DAROGRA/SmartBike/mcu avr game 5d rocker joystick.jpg

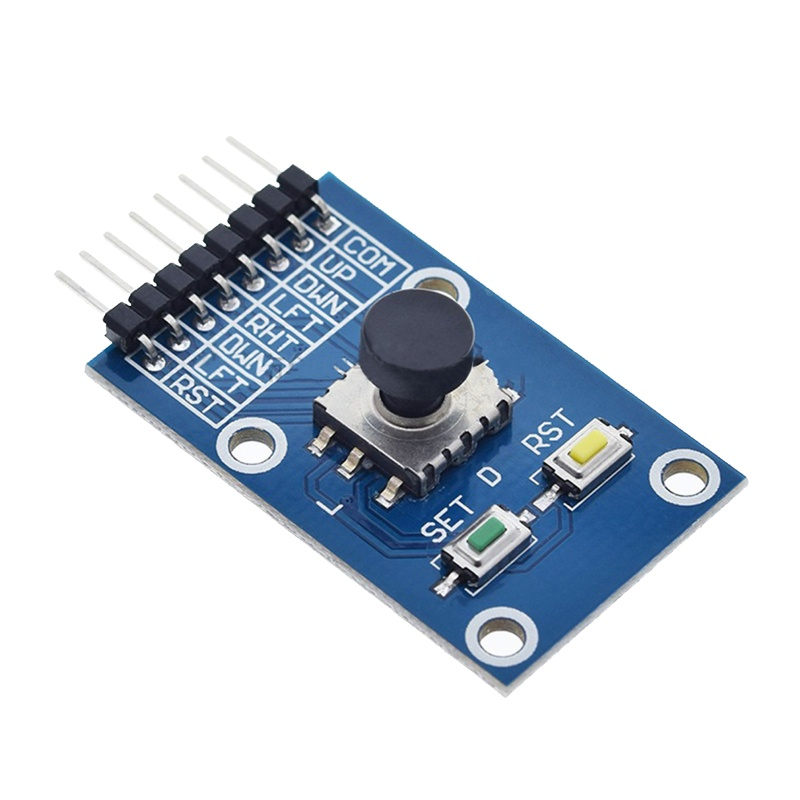
mcu avr game 5d rocker joystick.jpg
