DAROGRA/SmartBike/README.md

# SmartBike
 Proyecto Sistemas Embebidos, para mayor informacion visita la Wiki del proyecto
