DAROGRA/SmartBike/Primer diagrama de bloques.png

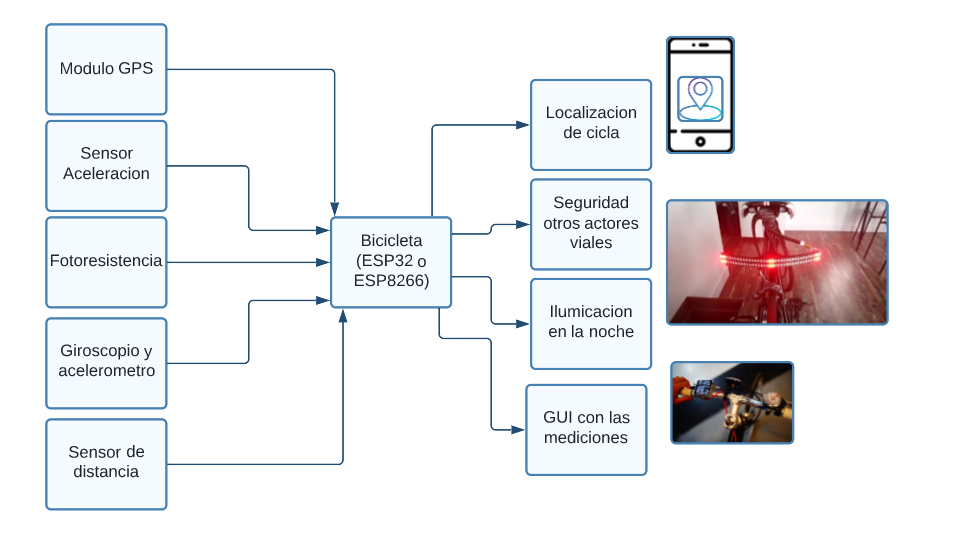
Primer diagrama de bloques.png
