DAROGRA/SmartBike/LIB_ESP32-WROVER-B__8MB_/ESP32-WROVER-B__8MB_/3D/ESP32-WROVER-B__8MB_.stp

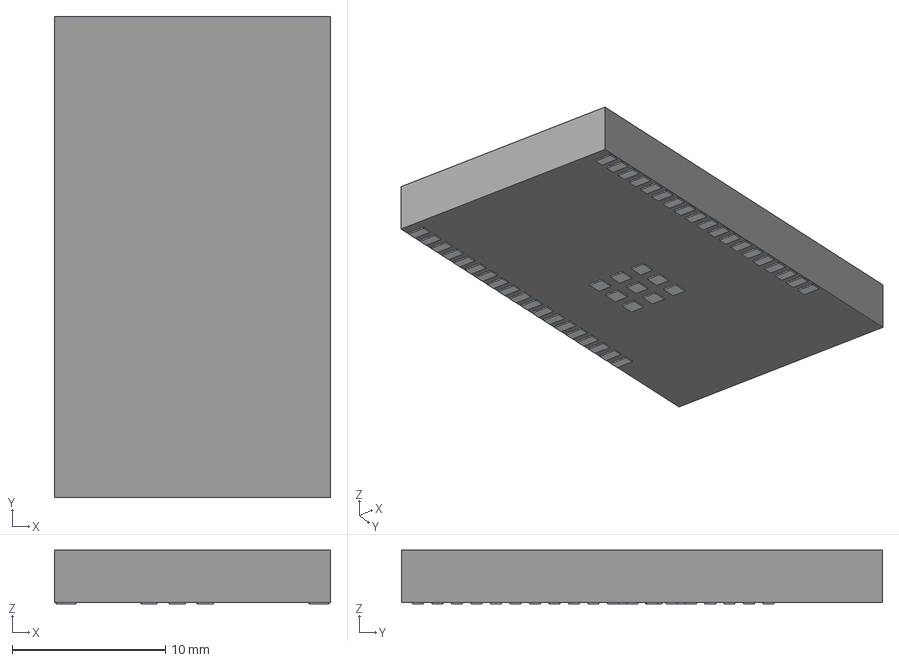
[picture p3: CAD file, 2022-10-04]
LIB_ESP32-WROVER-B__8MB_/ESP32-WROVER-B__8MB_/3D/ESP32-WROVER-B__8MB_.stp
18.0 x 31.4 x 3.50 mm
Pins
