DAROGRA/SmartBike/LIB_SIM800L/SIM800L/3D/SIM800L.stp

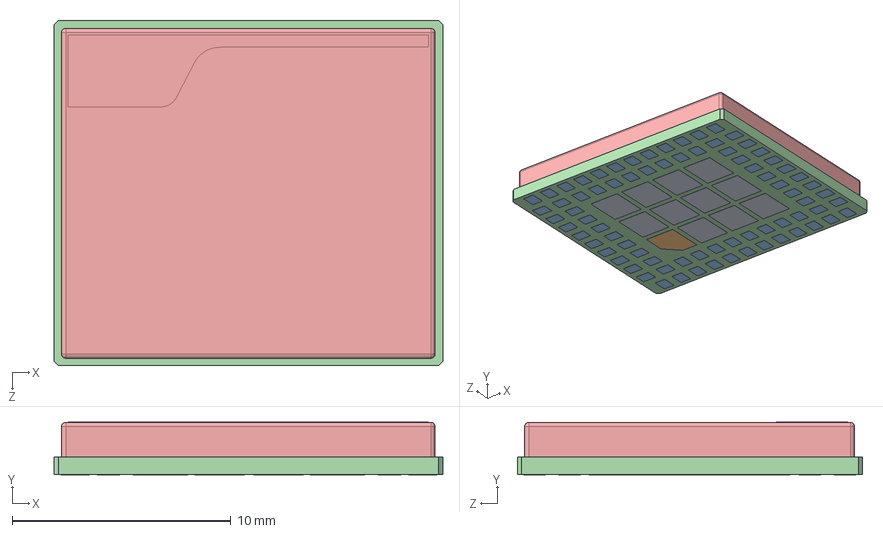
[picture p4: CAD file, 2022-10-04]
LIB_SIM800L/SIM800L/3D/SIM800L.stp
17.8 x 2.42 x 15.8 mm
Pads_D‚faut
PCB_D‚faut
Capot_DＧaut
