DAROGRA/SmartBike/(list of files, cad)

Other CAD files:
LIB_ESP32-WROVER-B__8MB_/ESP32-WROVER-B__8MB_/Allegro/esp32wroverb8mb.psm
LIB_ESP32-WROVER-B__8MB_/ESP32-WROVER-B__8MB_/DEHDL/esp32_wrover_b__8mb_/chips/chips.prt
LIB_NEO-M6-0-001/NEO-M6-0-001/Allegro/neo-m8u.psm
LIB_NEO-M6-0-001/NEO-M6-0-001/DEHDL/neo_m6_0_001/chips/chips.prt
LIB_SIM800L/SIM800L/Allegro/sim800l.psm
LIB_SIM800L/SIM800L/DEHDL/sim800l/chips/chips.prt
