DAROGRA/SmartBike/(list of files, drawings)

Other design files:
Embebidos/EsquemaGeneral.dsn
