DAROGRA/SmartBike/Embebidos/EsquemaGeneral.kicad_pcb

## KiCad design Embebidos/EsquemaGeneral.kicad_pcb (2022-10-22)

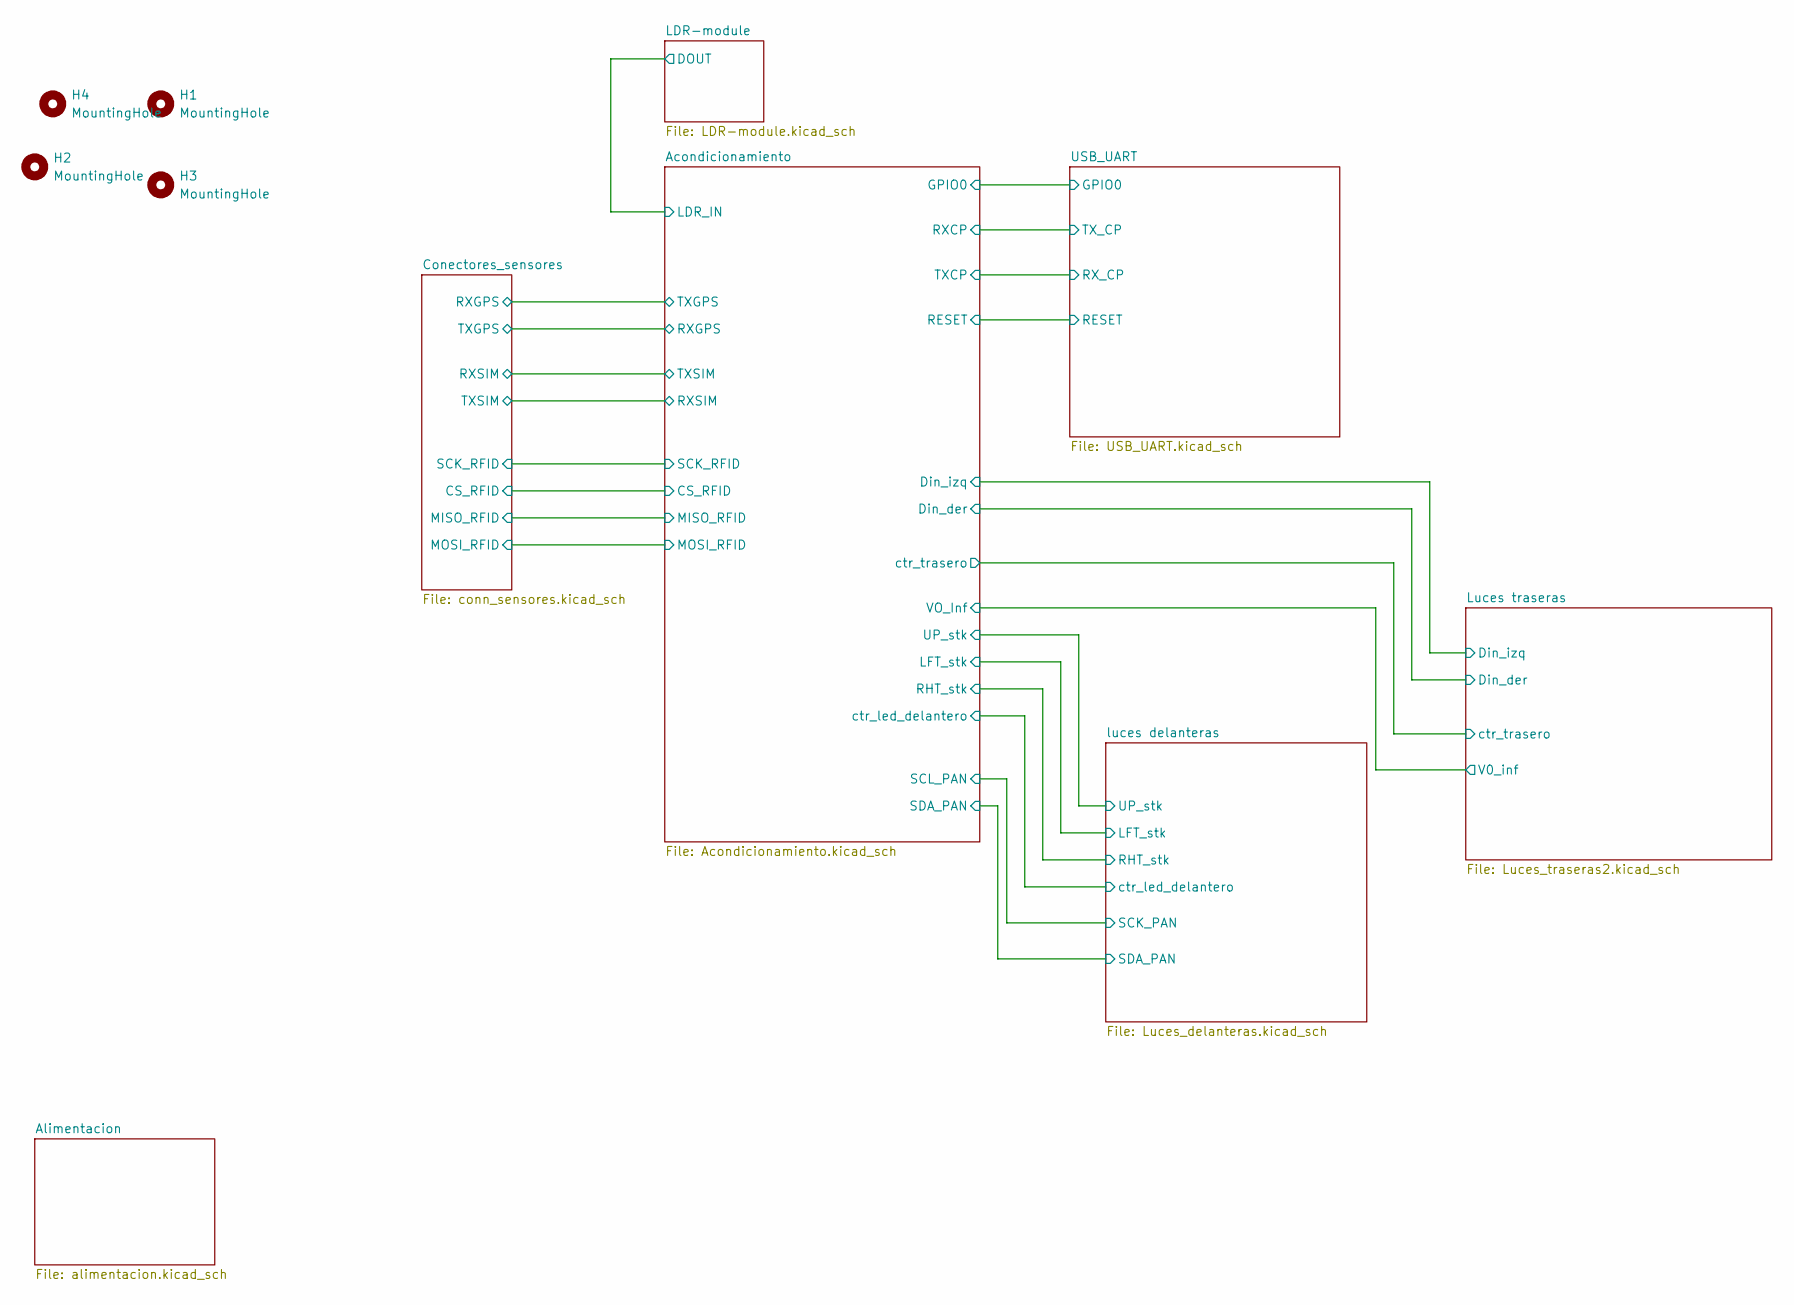
[picture p5: schematic EsquemaGeneral.kicad_sch]

Parts:
H1, H2, H3, H4: MountingHole; MountingHole_2.2mm_M2

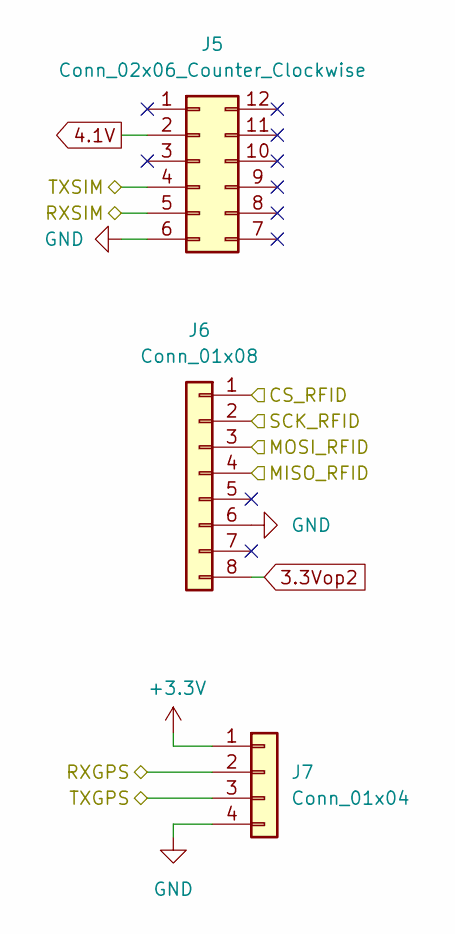
[picture p6: schematic conn_sensores.kicad_sch]

Parts:
J5: Conn_02x06_Counter_Clockwise; sim800l
J6: Conn_01x08; JST_EH_S8B-EH_1x08_P2.50mm_Horizontal
J7: Conn_01x04; JST_EH_B4B-EH-A_1x04_P2.50mm_Vertical

Connections:
3.3Vop2: J6.8; also elsewhere on the board
4.1V: J5.2; also elsewhere on the board
+3.3V: J7.1; also elsewhere on the board
/Acondicionamiento/CS_RFID: J6.1; also elsewhere on the board
/Acondicionamiento/MISO_RFID: J6.4; also elsewhere on the board
/Acondicionamiento/MOSI_RFID: J6.3; also elsewhere on the board
/Acondicionamiento/RXGPS: J7.3; also elsewhere on the board
/Acondicionamiento/RXSIM: J5.4; also elsewhere on the board
/Acondicionamiento/SCK_RFID: J6.2; also elsewhere on the board
/Acondicionamiento/TXGPS: J7.2; also elsewhere on the board
/Acondicionamiento/TXSIM: J5.5; also elsewhere on the board
GND: J5.6, J6.6, J7.4; also elsewhere on the board

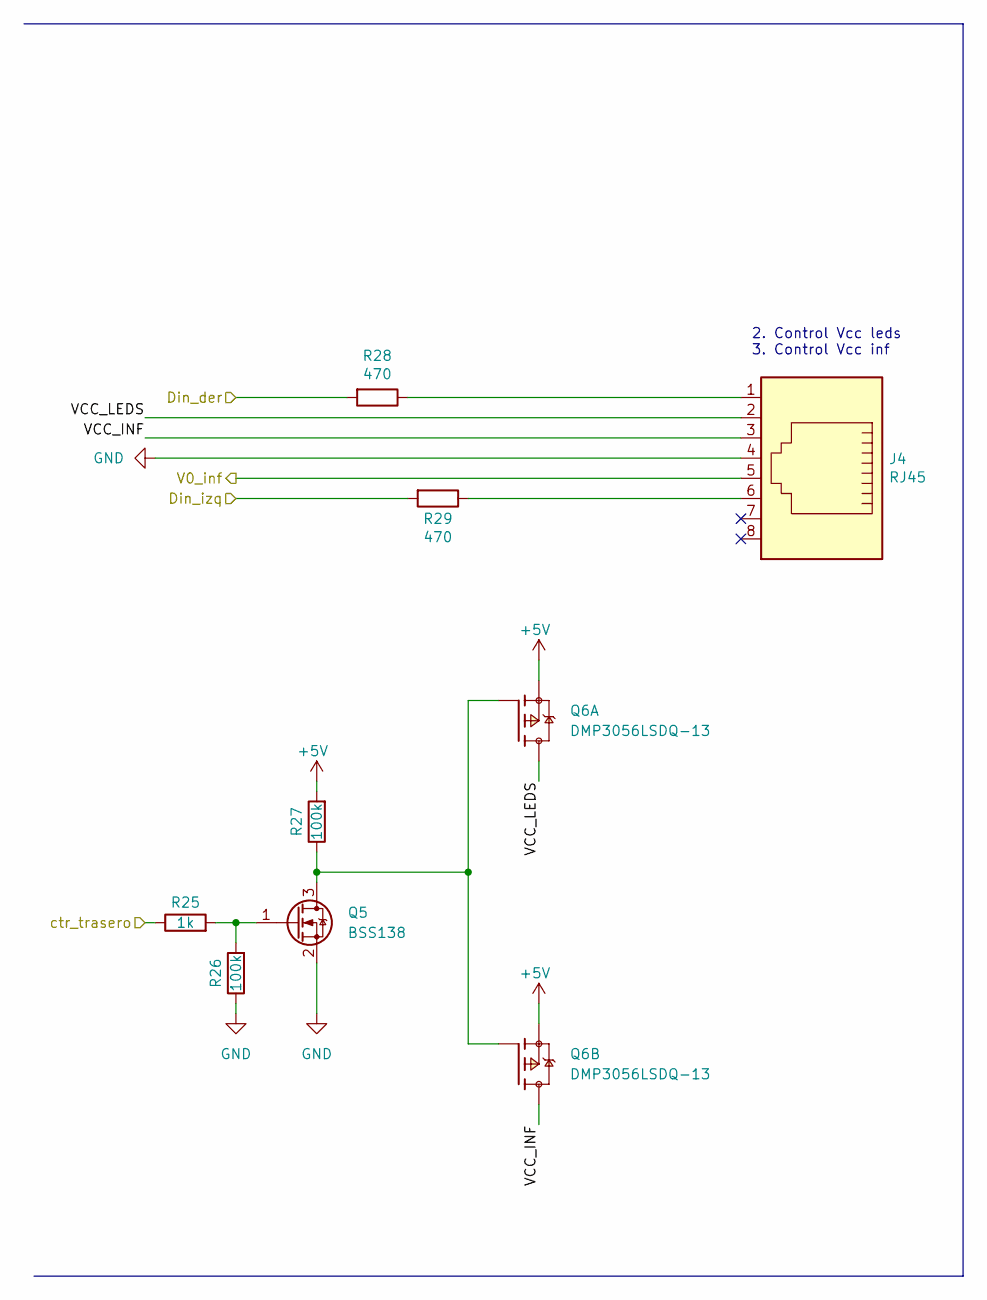
[picture p7: schematic Luces_traseras2.kicad_sch]

Parts:
J4: RJ45; RJ45_Amphenol_54602-x08_Horizontal
Q5: BSS138; SOT-23
Q6: DMP3056LSDQ-13; SOIC127P600X175-8N; PARTREV 1-2
R25: 1k; R_0805_2012Metric_Pad1.20x1.40mm_HandSolder
R26, R27: 100k; R_0805_2012Metric_Pad1.20x1.40mm_HandSolder
R28, R29: 470; R_0805_2012Metric_Pad1.20x1.40mm_HandSolder

Connections:
+5V: Q6.1, Q6.3, R27.2; also elsewhere on the board
/Acondicionamiento/Din_der: R28.2; also elsewhere on the board
/Acondicionamiento/Din_izq: R29.2; also elsewhere on the board
/Acondicionamiento/VO_Inf: J4.5; also elsewhere on the board
/Acondicionamiento/ctr_trasero: R25.1; also elsewhere on the board
/Luces traseras/VCC_INF: J4.3, Q6.5, Q6.6
/Luces traseras/VCC_LEDS: J4.2, Q6.7, Q6.8
GND: J4.4, Q5.2 (S), R26.1; also elsewhere on the board
unnamed: J4.1, R28.1
unnamed: J4.6, R29.1
unnamed: Q5.1 (G), R25.2, R26.2
unnamed: Q5.3 (D), Q6.2, Q6.4, R27.1

Notes on the sheet:
2. Control Vcc leds 3. Control Vcc inf

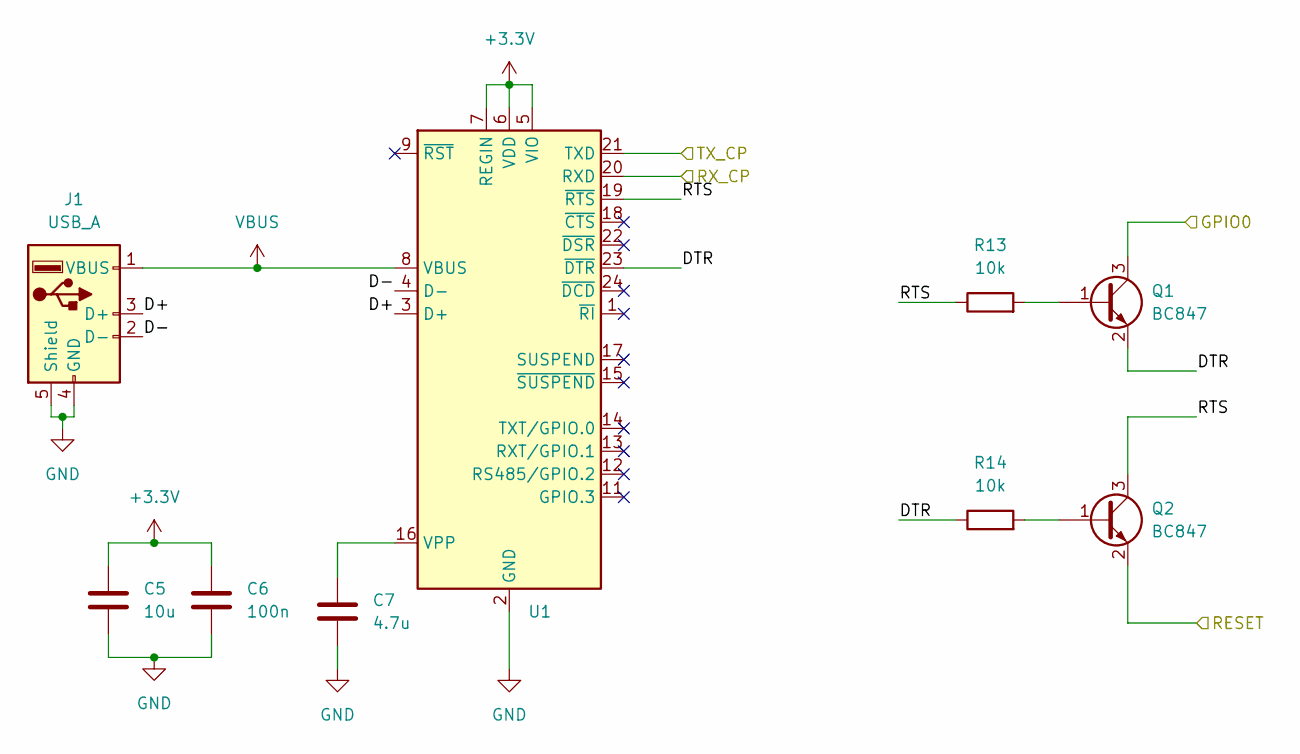
[picture p8: schematic USB_UART.kicad_sch]

Parts:
C5: 10u; C_0805_2012Metric_Pad1.18x1.45mm_HandSolder
C6: 100n; C_0805_2012Metric_Pad1.18x1.45mm_HandSolder
C7: 4.7u; C_0805_2012Metric_Pad1.18x1.45mm_HandSolder
J1: USB_A; USB_A_CNCTech_1001-011-01101_Horizontal
Q1, Q2: BC847; SOT23
R13, R14: 10k; R_0805_2012Metric_Pad1.20x1.40mm_HandSolder
U1: QFN50P400X400X80-25N

Connections:
+3.3V: C5.1, C6.1, U1.5 (VIO), U1.6 (VDD), U1.7 (REGIN); also elsewhere on the board
/Acondicionamiento/GPIO0: Q1.3 (C); also elsewhere on the board
/Acondicionamiento/RESET: Q2.2 (E); also elsewhere on the board
/Acondicionamiento/RXCP: U1.21 (TXD); also elsewhere on the board
/Acondicionamiento/TXCP: U1.20 (RXD); also elsewhere on the board
/USB_UART/D+: J1.3 (D+), U1.3 (D+)
/USB_UART/D-: J1.2 (D-), U1.4 (D-)
/USB_UART/DTR: Q1.2 (E), R14.1, U1.23 (~DTR)
/USB_UART/RTS: Q2.3 (C), R13.1, U1.19 (~RTS)
GND: C5.2, C6.2, C7.2, J1.4 (GND), J1.5 (Shield), U1.2 (GND), U1.25 (GND); also elsewhere on the board
unnamed: C7.1, U1.16 (VPP)
unnamed: Q1.1 (B), R13.2
unnamed: Q2.1 (B), R14.2
VBUS: J1.1 (VBUS), U1.8 (VBUS)

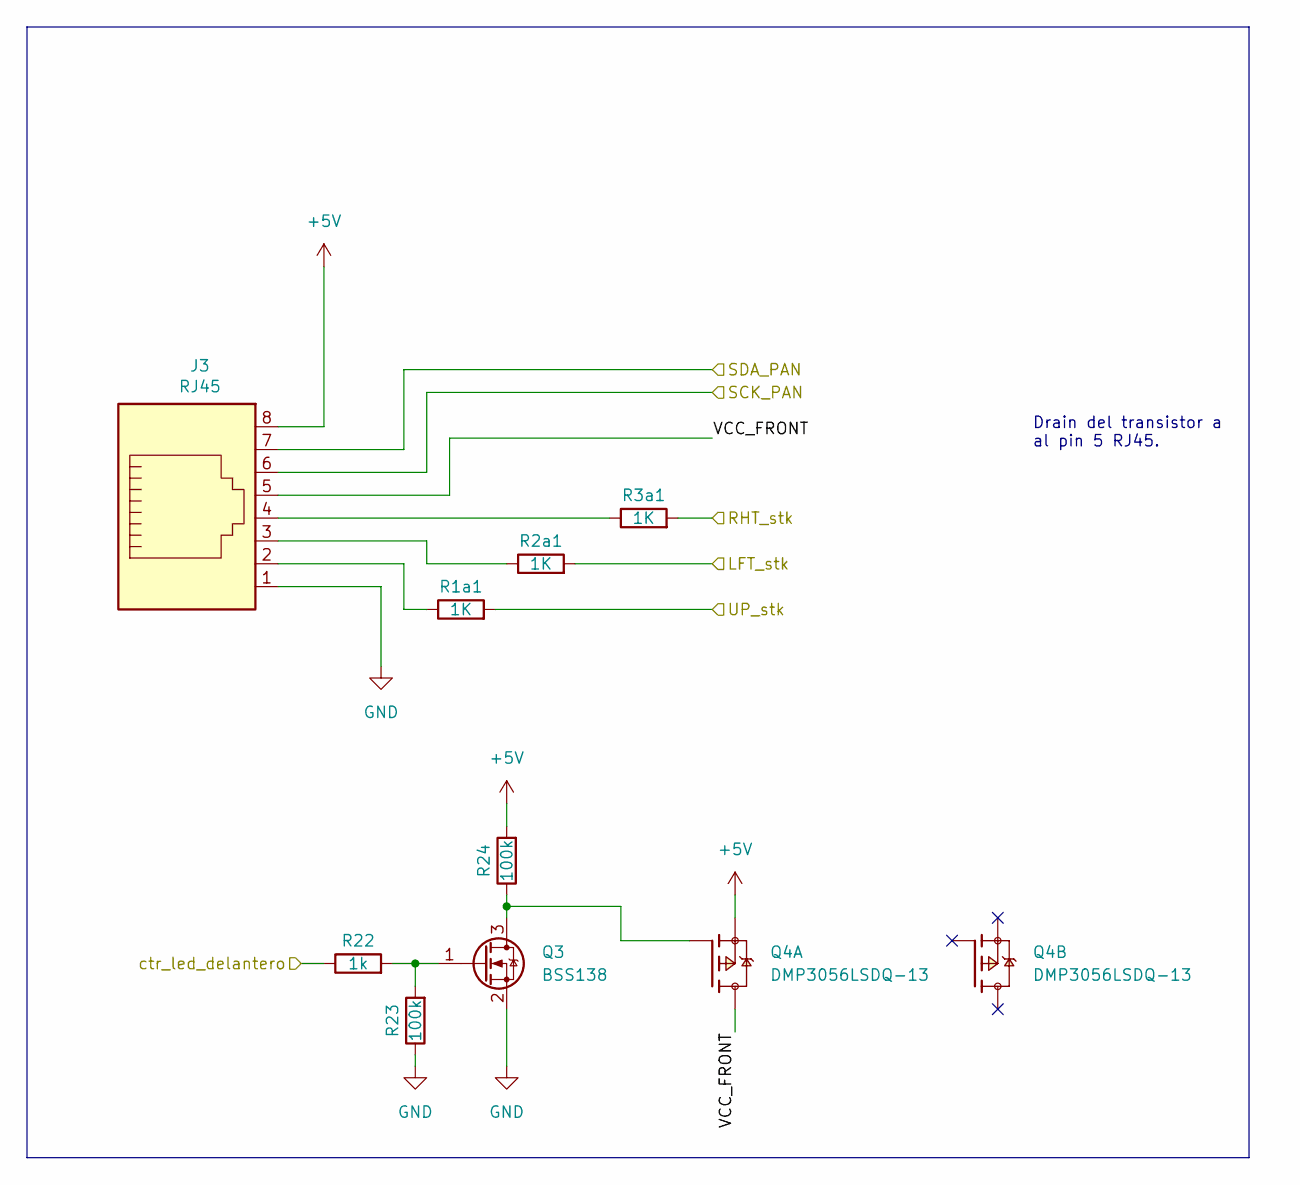
[picture p9: schematic Luces_delanteras.kicad_sch]

Parts:
J3: RJ45; RJ45_Amphenol_54602-x08_Horizontal
Q3: BSS138; SOT-23
Q4: DMP3056LSDQ-13; SOIC127P600X175-8N; PARTREV 1-2
R1a1, R2a1, R3a1: 1K; R_0805_2012Metric_Pad1.20x1.40mm_HandSolder
R22: 1k; R_0805_2012Metric_Pad1.20x1.40mm_HandSolder
R23, R24: 100k; R_0805_2012Metric_Pad1.20x1.40mm_HandSolder

Connections:
+5V: J3.8, Q4.1, R24.2; also elsewhere on the board
/Acondicionamiento/LFT_stk: R2a1.2; also elsewhere on the board
/Acondicionamiento/RHT_stk: R3a1.2; also elsewhere on the board
/Acondicionamiento/SCL_PAN: J3.6; also elsewhere on the board
/Acondicionamiento/SDA_PAN: J3.7; also elsewhere on the board
/Acondicionamiento/UP_stk: R1a1.2; also elsewhere on the board
/Acondicionamiento/ctr_led_delantero: R22.1; also elsewhere on the board
/luces delanteras/VCC_FRONT: J3.5, Q4.7, Q4.8
GND: J3.1, Q3.2 (S), R23.1; also elsewhere on the board
unnamed: J3.2, R1a1.1
unnamed: J3.3, R2a1.1
unnamed: J3.4, R3a1.1
unnamed: Q3.1 (G), R22.2, R23.2
unnamed: Q3.3 (D), Q4.2, R24.1

Notes on the sheet:
Drain del transistor a al pin 5 RJ45.

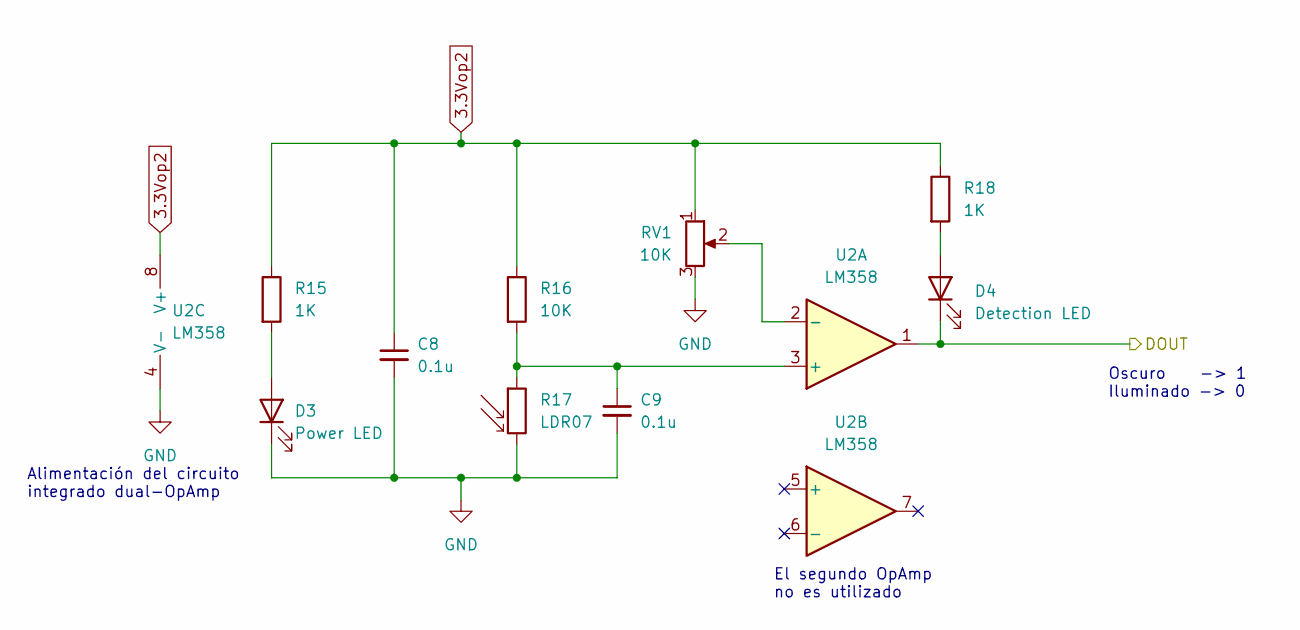
[picture p10: schematic LDR-module.kicad_sch]

Parts:
C8, C9: 0.1u; C_0805_2012Metric_Pad1.18x1.45mm_HandSolder
D3: Power LED; LED_0805_2012Metric_Pad1.15x1.40mm_HandSolder
D4: Detection LED; LED_0805_2012Metric_Pad1.15x1.40mm_HandSolder
R15, R18: 1K; R_0805_2012Metric_Pad1.20x1.40mm_HandSolder
R16: 10K; R_0805_2012Metric_Pad1.20x1.40mm_HandSolder
R17: LDR07; R_LDR_5.1x4.3mm_P3.4mm_Vertical
RV1: 10K; Potentiometer_Bourns_3386P_Vertical
U2: LM358; SOIC127P599X175-8N

Connections:
3.3Vop2: C8.1, R15.1, R16.1, R18.1, RV1.1, U2.8 (V+); also elsewhere on the board
/Acondicionamiento/LDR_IN: D4.1 (K), U2.1; also elsewhere on the board
GND: C8.2, C9.2, D3.1 (K), R17.2, RV1.3, U2.4 (V-); also elsewhere on the board
unnamed: C9.1, R16.2, R17.1, U2.3 (+)
unnamed: D3.2 (A), R15.2
unnamed: D4.2 (A), R18.2
unnamed: RV1.2, U2.2 (-)

Notes on the sheet:
El segundo OpAmp no es utilizado
Alimentación del circuito integrado dual-OpAmp
Oscuro -> 1 Iluminado -> 0

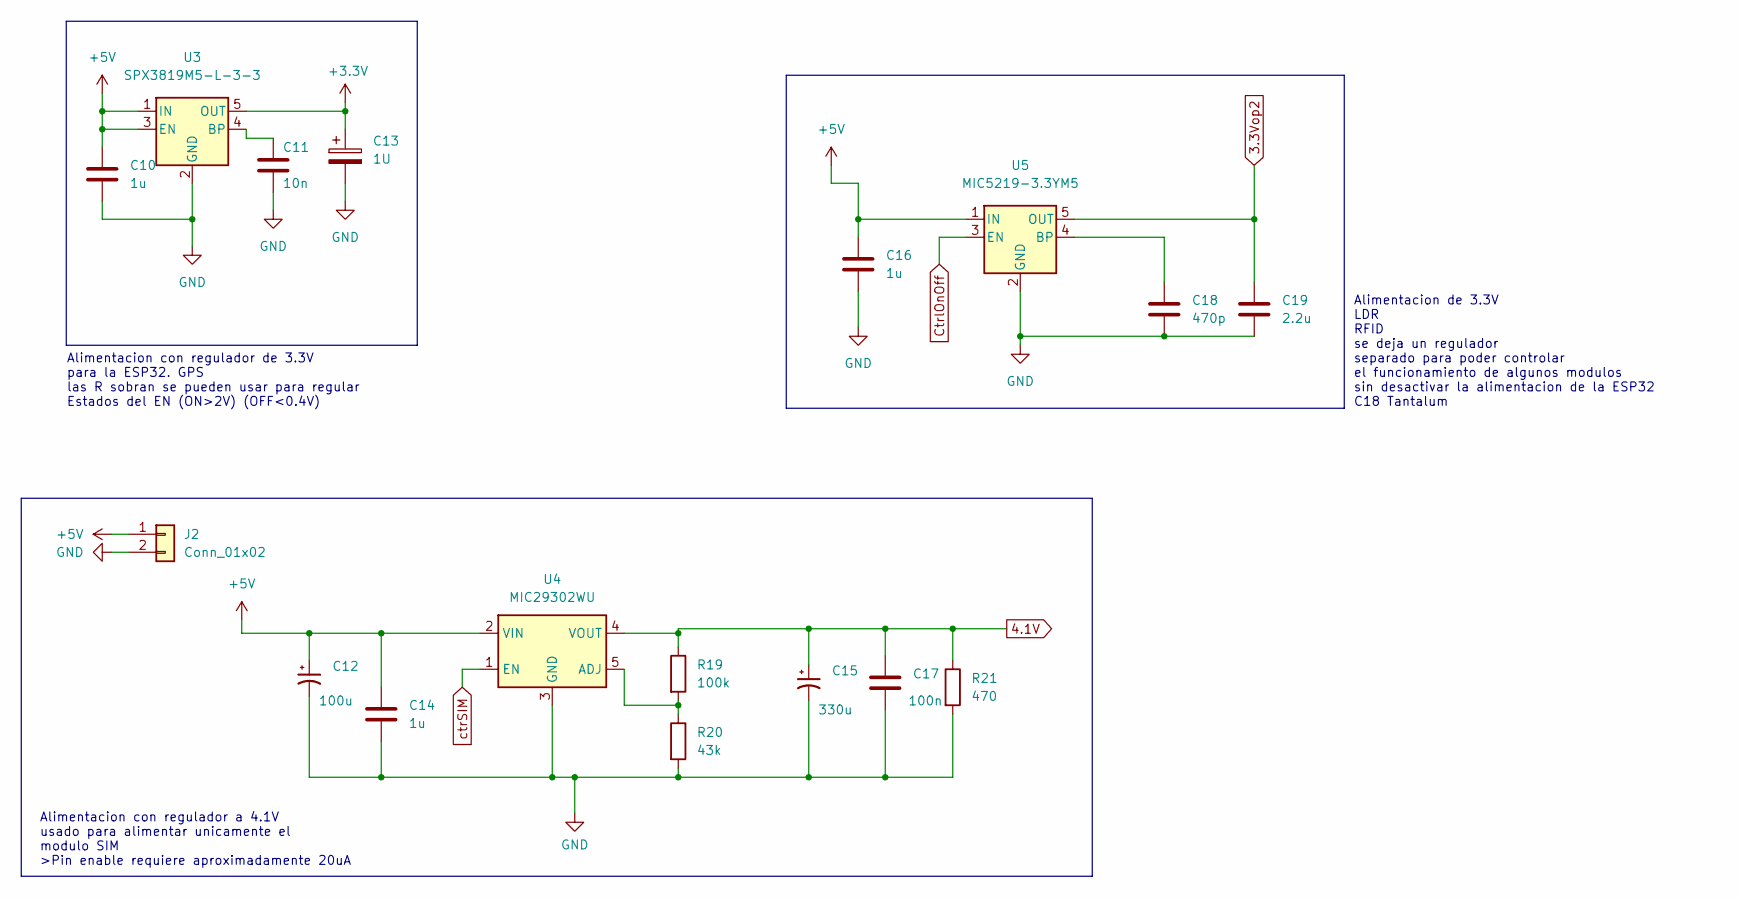
[picture p11: schematic alimentacion.kicad_sch]

Parts:
C10, C14, C16: 1u; C_0805_2012Metric_Pad1.18x1.45mm_HandSolder
C11: 10n; C_0805_2012Metric_Pad1.18x1.45mm_HandSolder
C12: 100u; CP_EIA-6032-28_Kemet-C_Pad2.25x2.35mm_HandSolder
C13: 1U; CP_EIA-3216-18_Kemet-A_Pad1.58x1.35mm_HandSolder
C15: 330u; CP_Elec_8x10.5
C17: 100n; C_0805_2012Metric_Pad1.18x1.45mm_HandSolder
C18: 470p; C_0805_2012Metric_Pad1.18x1.45mm_HandSolder
C19: 2.2u; CP_EIA-3216-18_Kemet-A_Pad1.58x1.35mm_HandSolder
J2: Conn_01x02; JST_EH_S2B-EH_1x02_P2.50mm_Horizontal
R19: 100k; R_0805_2012Metric_Pad1.20x1.40mm_HandSolder
R20: 43k; R_1206_3216Metric_Pad1.30x1.75mm_HandSolder
R21: 470; R_0805_2012Metric_Pad1.20x1.40mm_HandSolder
U3: SPX3819M5-L-3-3; SOT-23-5
U4: MIC29302WU; TO-263-5_TabPin3
U5: MIC5219-3.3YM5; SOT-23-5

Connections:
3.3Vop2: C19.1, U5.5 (OUT); also elsewhere on the board
4.1V: C15.1, C17.1, R19.1, R21.1, U4.4 (VOUT); also elsewhere on the board
+3.3V: C13.1, U3.5 (OUT); also elsewhere on the board
+5V: C10.1, C12.1, C14.1, C16.1, J2.1, U3.1 (IN), U3.3 (EN), U4.2 (VIN), U5.1 (IN); also elsewhere on the board
CtrlOnOff: U5.3 (EN); also elsewhere on the board
GND: C10.2, C11.2, C12.2, C13.2, C14.2, C15.2, C16.2, C17.2, C18.2, C19.2, J2.2, R20.2, R21.2, U3.2 (GND), U4.3 (GND), U5.2 (GND); also elsewhere on the board
unnamed: C11.1, U3.4 (BP)
unnamed: C18.1, U5.4 (BP)
unnamed: R19.2, R20.1, U4.5 (ADJ)
ctrSIM: U4.1 (EN); also elsewhere on the board

Notes on the sheet:
Alimentacion de 3.3V LDR RFID se deja un regulador separado para poder controlar el funcionamiento de algunos modulos sin desactivar la alimentacion de la ESP32 C18 Tantalum
Alimentacion con regulador a 4.1V usado para alimentar unicamente el modulo SIM >Pin enable requiere aproximadamente 20uA
Alimentacion con regulador de 3.3V para la ESP32. GPS las R sobran se pueden usar para regular Estados del EN (ON>2V) (OFF<0.4V)

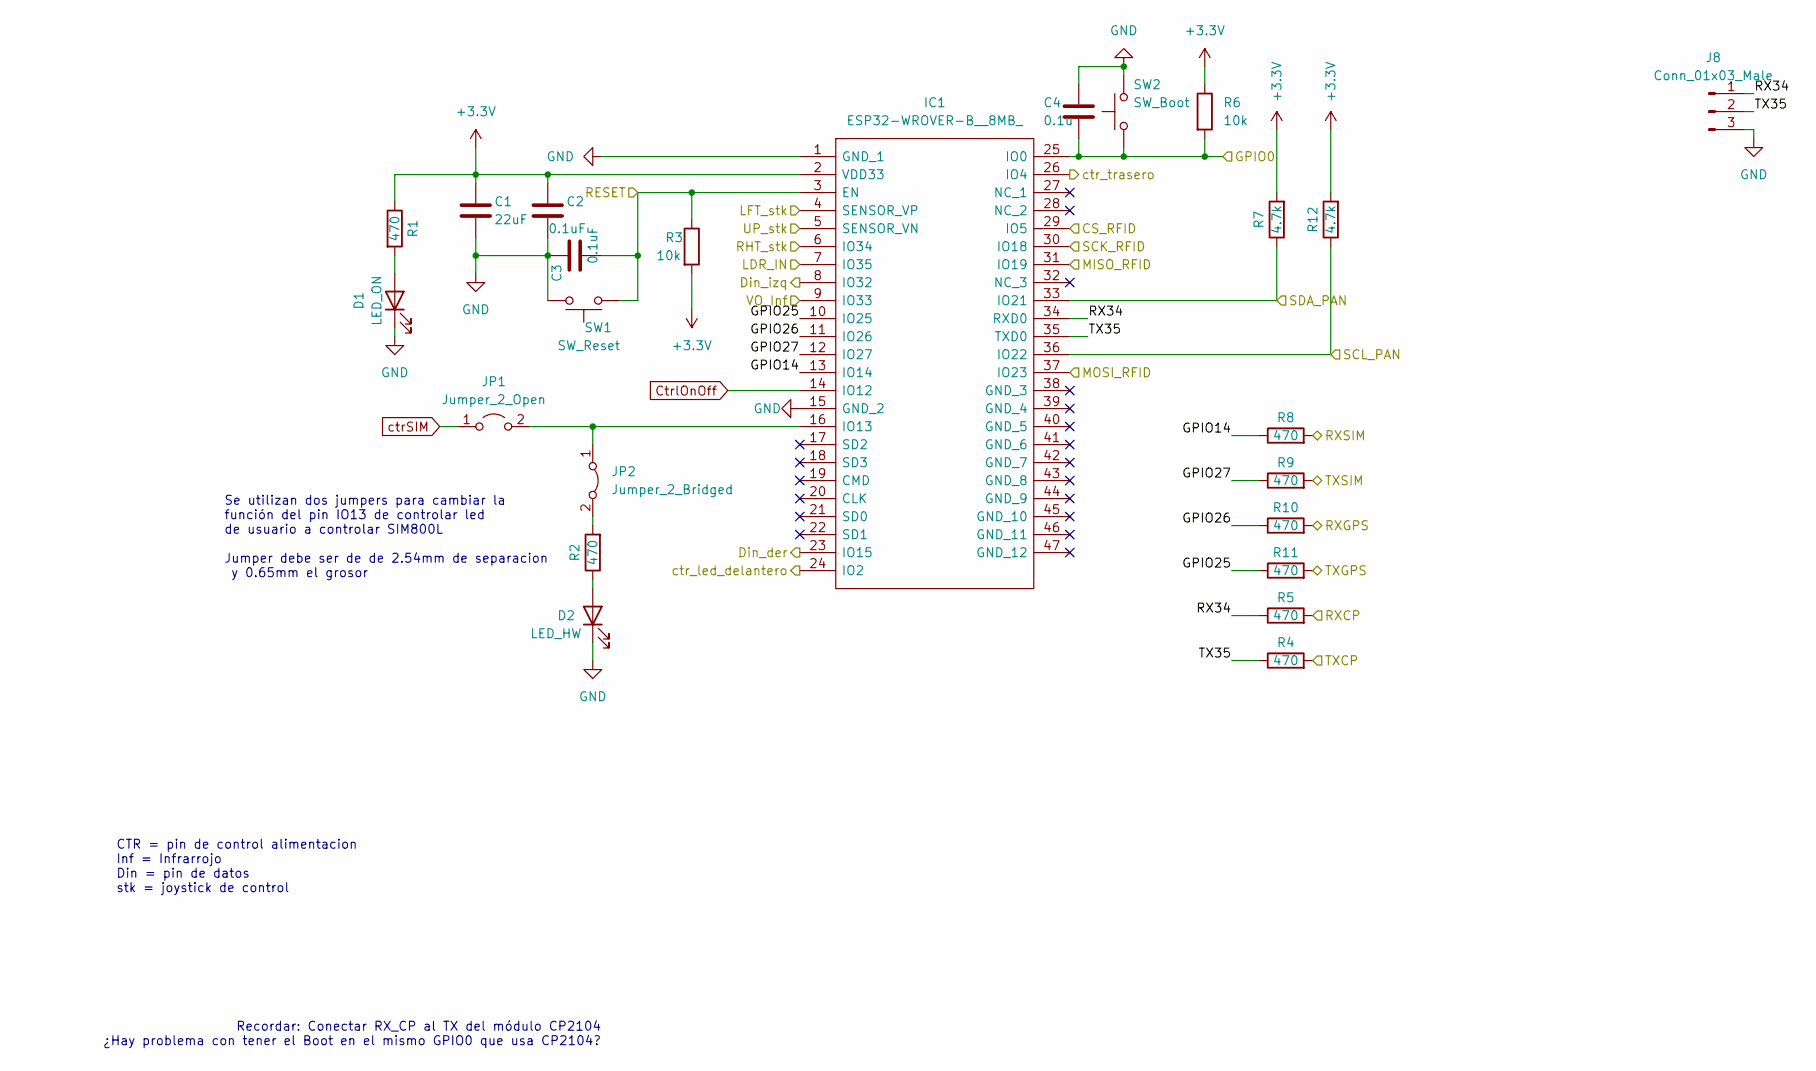
[picture p12: schematic Acondicionamiento.kicad_sch]

Parts:
C1: 22uF; C_0805_2012Metric_Pad1.18x1.45mm_HandSolder
C2, C3: 0.1uF; C_0805_2012Metric_Pad1.18x1.45mm_HandSolder
C4: 0.1u; C_0805_2012Metric_Pad1.18x1.45mm_HandSolder
D1: LED_ON; LED_0805_2012Metric_Pad1.15x1.40mm_HandSolder
D2: LED_HW; LED_0805_2012Metric_Pad1.15x1.40mm_HandSolder
IC1: ESP32-WROVER-B__8MB_; ESP32WROVERB8MB; Manufacturer_Part_Number ESP32-WROVER-B (8MB); Mouser Part Number 356-ESP32-WRO-B(8MB)
J8: Conn_01x03_Male; PinHeader_1x03_P2.54mm_Vertical
JP1: Jumper_2_Open; PinHeader_1x02_P2.54mm_Vertical
JP2: Jumper_2_Bridged; PinHeader_1x02_P2.54mm_Vertical
R1, R2, R4, R5, R8, R9, R10, R11: 470; R_0805_2012Metric_Pad1.20x1.40mm_HandSolder
R3, R6: 10k; R_0805_2012Metric_Pad1.20x1.40mm_HandSolder
R7, R12: 4.7k; R_0805_2012Metric_Pad1.20x1.40mm_HandSolder
SW1: SW_Reset; pulsador
SW2: SW_Boot; pulsador

Connections:
+3.3V: C1.1, C2.1, IC1.2 (VDD33), R1.1, R3.2, R6.1, R7.2, R12.2; also elsewhere on the board
/Acondicionamiento/CS_RFID: IC1.29 (IO5); also elsewhere on the board
/Acondicionamiento/Din_der: IC1.23 (IO15); also elsewhere on the board
/Acondicionamiento/Din_izq: IC1.8 (IO32); also elsewhere on the board
/Acondicionamiento/GPIO0: C4.2, IC1.25 (IO0), R6.2, SW2.1; also elsewhere on the board
/Acondicionamiento/GPIO14: IC1.13 (IO14), R8.1
/Acondicionamiento/GPIO25: IC1.10 (IO25), R11.1
/Acondicionamiento/GPIO26: IC1.11 (IO26), R10.1
/Acondicionamiento/GPIO27: IC1.12 (IO27), R9.1
/Acondicionamiento/LDR_IN: IC1.7 (IO35); also elsewhere on the board
/Acondicionamiento/LFT_stk: IC1.4 (SENSOR_VP); also elsewhere on the board
/Acondicionamiento/MISO_RFID: IC1.31 (IO19); also elsewhere on the board
/Acondicionamiento/MOSI_RFID: IC1.37 (IO23); also elsewhere on the board
/Acondicionamiento/RESET: C3.2, IC1.3 (EN), R3.1, SW1.1; also elsewhere on the board
/Acondicionamiento/RHT_stk: IC1.6 (IO34); also elsewhere on the board
/Acondicionamiento/RX34: IC1.34 (RXD0), J8.1, R5.1
/Acondicionamiento/RXCP: R5.2; also elsewhere on the board
/Acondicionamiento/RXGPS: R10.2; also elsewhere on the board
/Acondicionamiento/RXSIM: R8.2; also elsewhere on the board
/Acondicionamiento/SCK_RFID: IC1.30 (IO18); also elsewhere on the board
/Acondicionamiento/SCL_PAN: IC1.36 (IO22), R12.1; also elsewhere on the board
/Acondicionamiento/SDA_PAN: IC1.33 (IO21), R7.1; also elsewhere on the board
/Acondicionamiento/TX35: IC1.35 (TXD0), J8.2, R4.1
/Acondicionamiento/TXCP: R4.2; also elsewhere on the board
/Acondicionamiento/TXGPS: R11.2; also elsewhere on the board
/Acondicionamiento/TXSIM: R9.2; also elsewhere on the board
/Acondicionamiento/UP_stk: IC1.5 (SENSOR_VN); also elsewhere on the board
/Acondicionamiento/VO_Inf: IC1.9 (IO33); also elsewhere on the board
/Acondicionamiento/ctr_led_delantero: IC1.24 (IO2); also elsewhere on the board
/Acondicionamiento/ctr_trasero: IC1.26 (IO4); also elsewhere on the board
CtrlOnOff: IC1.14 (IO12); also elsewhere on the board
GND: C1.2, C2.2, C3.1, C4.1, D1.1 (K), D2.1 (K), IC1.1 (GND_1), IC1.15 (GND_2), J8.3, SW1.2, SW2.2; also elsewhere on the board
unnamed: D1.2 (A), R1.2
unnamed: D2.2 (A), R2.1
unnamed: IC1.16 (IO13), JP1.2 (B), JP2.1 (A)
unnamed: JP2.2 (B), R2.2
ctrSIM: JP1.1 (A); also elsewhere on the board

Notes on the sheet:
Recordar: Conectar RX_CP al TX del módulo CP2104 ¿Hay problema con tener el Boot en el mismo GPIO0 que usa CP2104?
Se utilizan dos jumpers para cambiar la función del pin IO13 de controlar led de usuario a controlar SIM800L Jumper debe ser de de 2.54mm de separacion y 0.65mm el grosor
CTR = pin de control alimentacion Inf = Infrarrojo Din = pin de datos stk = joystick de control

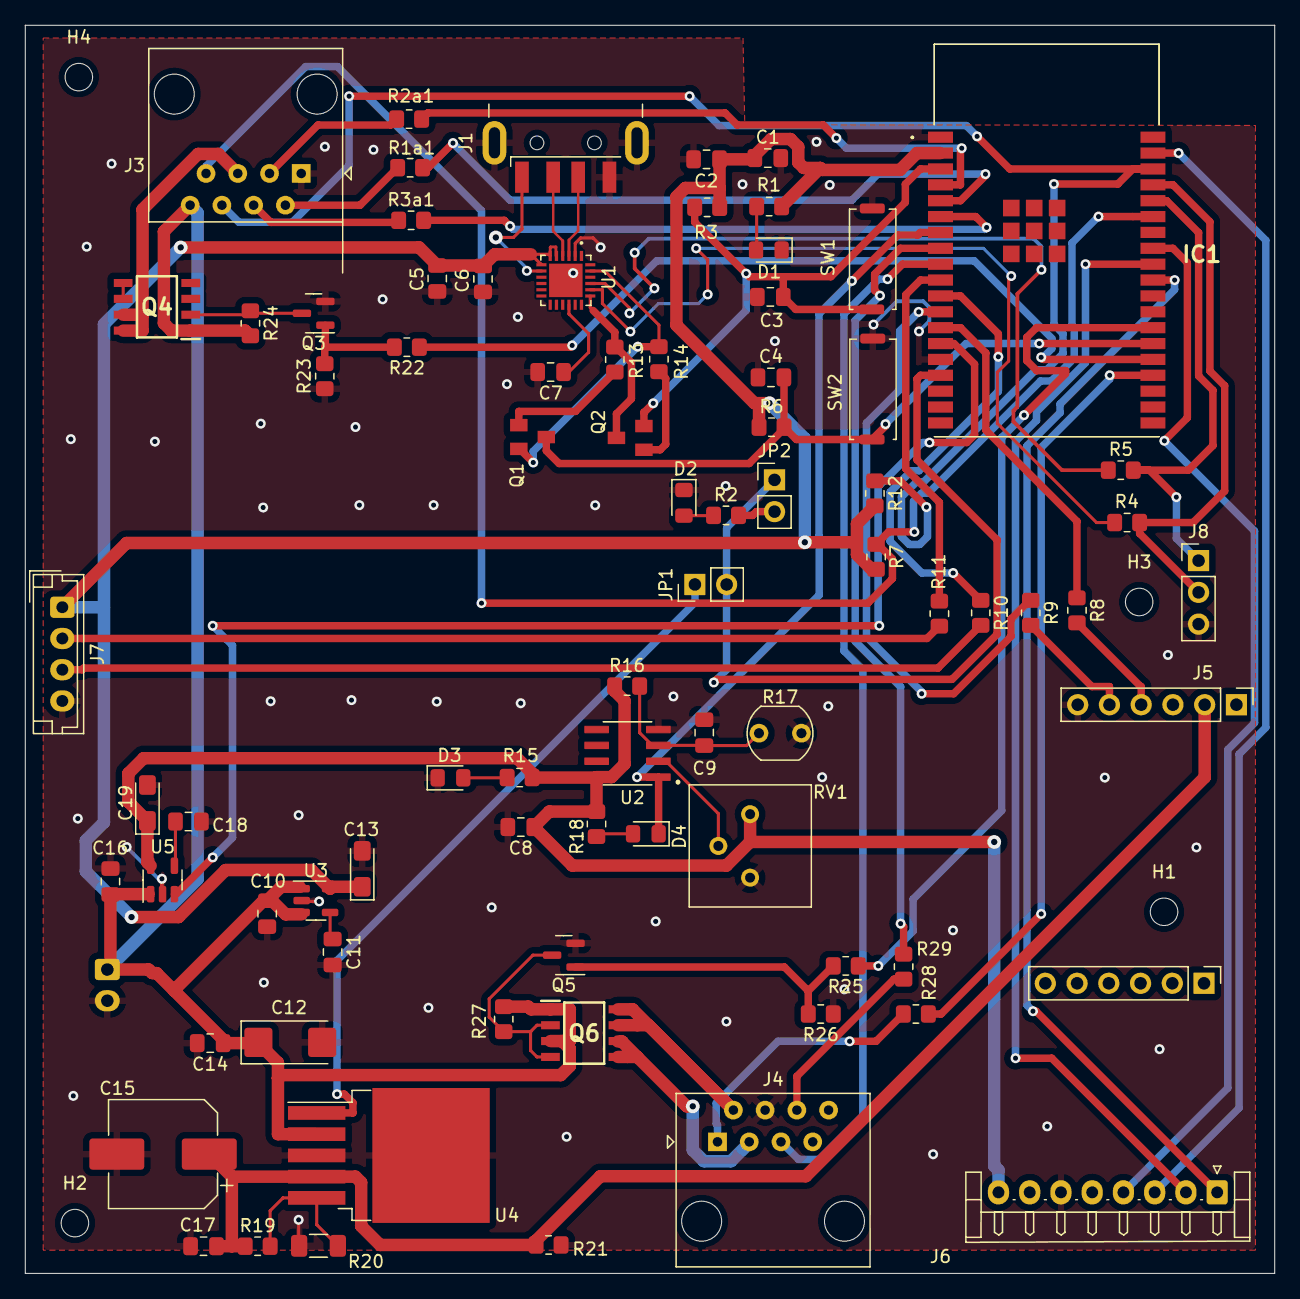
[picture p13: board EsquemaGeneral.kicad_pcb from above]

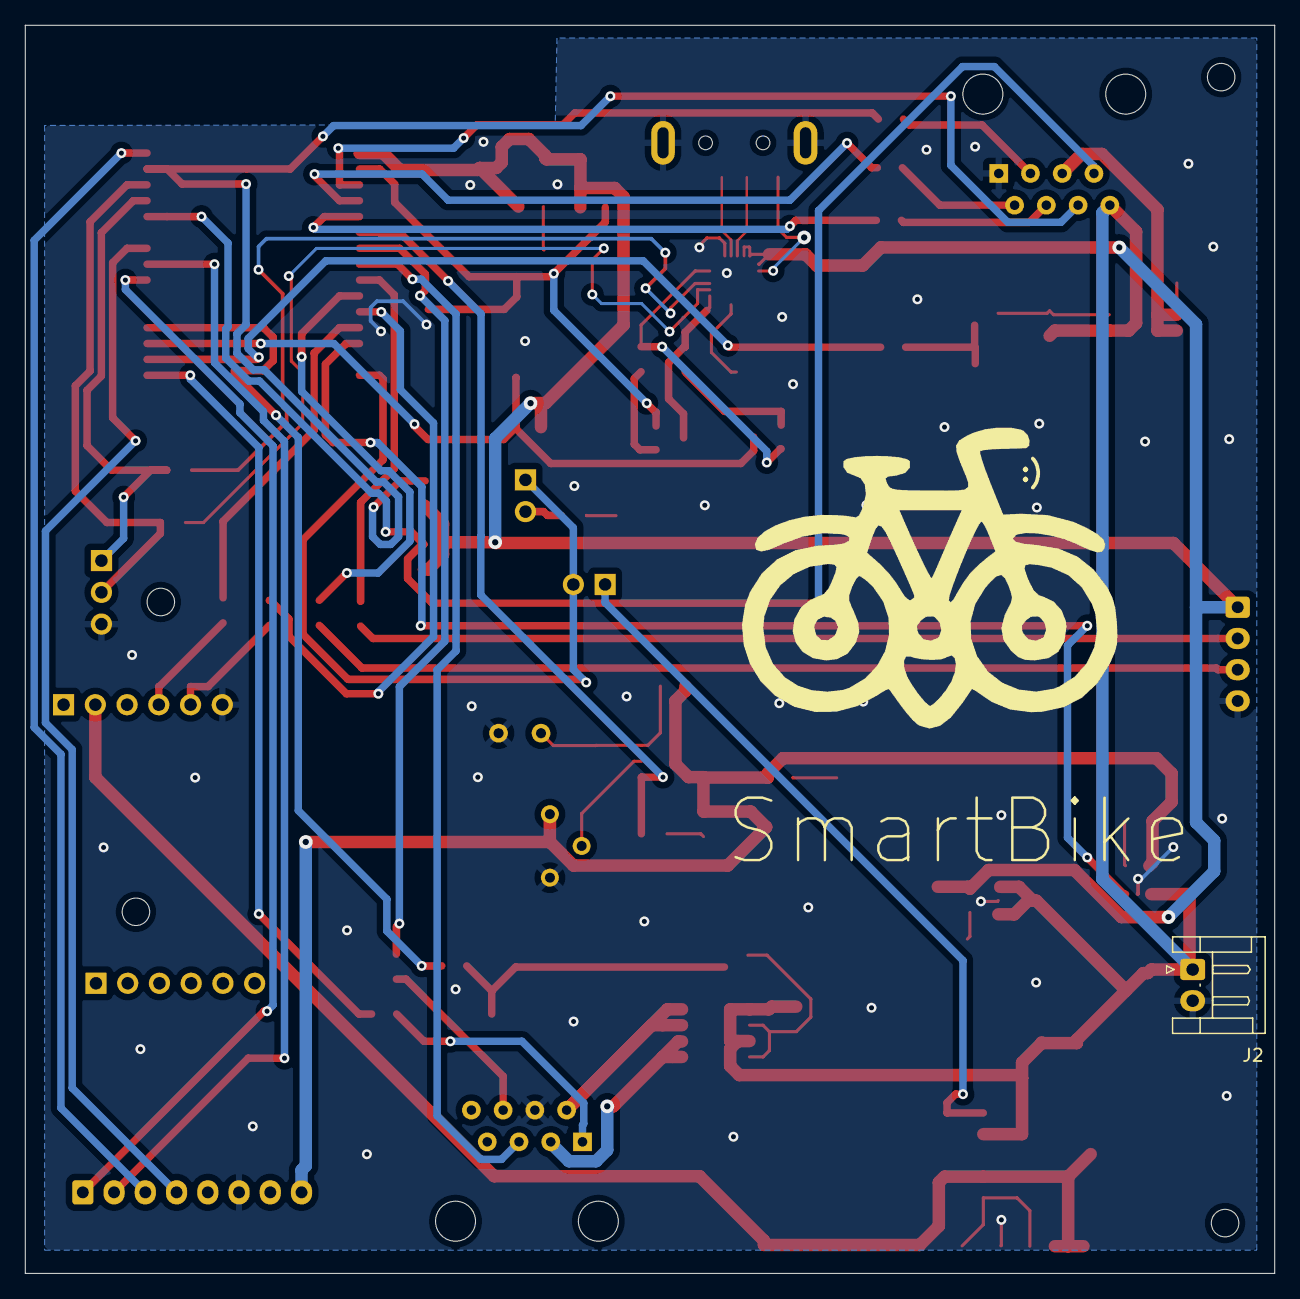
[picture p14: board EsquemaGeneral.kicad_pcb from below]

Board: 2 copper layers, 100.0 x 99.9 mm, 85 parts (2 on the bottom side), 67 nets.

Other parts of the board:
:): LOGO; Logonuevo
