DAROGRA/SmartBike/(commit log)

2022-09-08 Add files via upload
    sensor infrarrojo
2022-10-04 incluí ESP32 y USB_UART
    [Acondicionamiento.kicad_sch, EDI2CAP.CFG, ESP32-WROVER-B__8MB_.stp, EsquemaGeneral.kicad_sch, SIM800L.stp, USB_UART.kicad_sch, chips.prt, esp32wroverb8mb.psm]
2022-10-04 LDR module adittion
    [Acondicionamiento.kicad_sch, EsquemaGeneral.kicad_sch, LDR-module.kicad_sch]
2022-10-05 Corrección de anotaciones
    [Acondicionamiento.kicad_sch, EsquemaGeneral.kicad_sch, LDR-module.kicad_sch, USB_UART.kicad_sch, alimentacion.kicad_sch]
2022-10-06 Luces delanteras, traseras, pantalla, e infrarrojo
    [Acondicionamiento.kicad_sch, EsquemaGeneral.kicad_sch, LDR-module.kicad_sch, Luces_delanteras.kicad_sch, Luces_traseras2.kicad_sch, Luces_traseras2.sch]
2022-10-11 Dtaasheet mosfetP
2022-10-11 Mosfet Luces
    [Acondicionamiento.kicad_sch, EsquemaGeneral.kicad_sch, Luces_traseras2.kicad_sch]
2022-10-12 mejoras alimentacion
    [alimentacion.kicad_sch]
2022-10-13 se agrego el Bonito
2022-10-13 correccion lul
    [EsquemaGeneral.kicad_sch, alimentacion.kicad_sch]
2022-10-13 cambio LDR
    [EsquemaGeneral.kicad_sch, LDR-module.kicad_sch]
2022-10-13 transistores traseros
    [Acondicionamiento.kicad_sch, EsquemaGeneral.kicad_sch, Luces_traseras2.kicad_sch, alimentacion.kicad_sch]
2022-10-13 Cambio de anotacion y Vcc ldr
    [Acondicionamiento.kicad_sch, EsquemaGeneral.kicad_sch, LDR-module.kicad_sch, Luces_delanteras.kicad_sch, Luces_traseras2.kicad_sch, USB_UART.kicad_sch, alimentacion.kicad_sch]
2022-10-13 Cambios varios
    -Conectores movidos a nueva hoja jerarquica
    -Transistores DMP colocados en lices delanteras
    -Jumpers ubicados para el uso del pin IO13 para SIM800 y LEDHW
    -Etiqueta de "no conectado" ubicada en USB_UART
    [Acondicionamiento.kicad_sch, EsquemaGeneral.kicad_sch, LDR-module.kicad_sch, Luces_delanteras.kicad_sch, Luces_traseras2.kicad_sch, USB_UART.kicad_sch, alimentacion.kicad_sch, conn_sensores.kicad_sch]
2022-10-17 Correccion Errores
    [Acondicionamiento.kicad_sch, EsquemaGeneral.kicad_sch, Luces_delanteras.kicad_sch, Luces_traseras2.kicad_sch, USB_UART.kicad_sch, alimentacion.kicad_sch, conn_sensores.kicad_sch]
2022-10-17 Correccion errores y huellas leds LDR
    [Acondicionamiento.kicad_sch, EsquemaGeneral.kicad_sch, LDR-module.kicad_sch, Luces_delanteras.kicad_sch]
2022-10-18 Errores huellas
    [Acondicionamiento.kicad_sch, EsquemaGeneral.kicad_sch]
2022-10-18 panic
    no otra vez uwu
    [EsquemaGeneral.kicad_pcb]
2022-10-18 mas orden
    [EsquemaGeneral.kicad_pcb]
2022-10-19 orden pcb
    [EsquemaGeneral.kicad_pcb]
2022-10-19 se agregan cositasss
    [EsquemaGeneral.csv]
2022-10-19 mas orden en la ubicacion de huellas
    [Acondicionamiento.kicad_sch, EsquemaGeneral.kicad_pcb, EsquemaGeneral.kicad_sch, Luces_delanteras.kicad_sch, Luces_traseras2.kicad_sch, alimentacion.kicad_sch, conn_sensores.kicad_sch]
2022-10-20 ruteado pero toca corregirlo
    [EsquemaGeneral.dsn, EsquemaGeneral.kicad_pcb]
2022-10-21 mejora ubicacion de huellas
    [EsquemaGeneral.kicad_pcb, EsquemaGeneral.kicad_sch, alimentacion.kicad_sch]
2022-10-21 pistas gordas :(
    [EsquemaGeneral.dsn, EsquemaGeneral.kicad_pcb]
2022-10-21 no se uwu
    [EsquemaGeneral.kicad_pcb, EsquemaGeneral.kicad_sch, alimentacion.kicad_sch]
2022-10-21 Cambio huella Capacitor
    [EsquemaGeneral.kicad_pcb]
2022-10-21 eliminar pistas para volver a intetar
    :c
    [EsquemaGeneral.kicad_pcb]
2022-10-22 arreglo del uart feo y pequeño
    Gracias profeee por si acaso lee estooooo
    [EsquemaGeneral.kicad_pcb]
2022-10-22 arreglo serigrafias y rutas
    [EsquemaGeneral.kicad_pcb]
2022-10-22 queda un error
    [EsquemaGeneral.kicad_pcb]
2022-10-22 fix: track clearance cp2102x fixed
    [EsquemaGeneral.kicad_pcb, EsquemaGeneral.kicad_sch, USB_UART.kicad_sch]
2022-10-22 Revert "ai"
    This reverts commit 0a330e204fbdc8aac4303f8de6fa14c1261b352c, reversing
    changes made to c8426c30f6ece7c381f77537cb0de3e4f23fbe4e.
    [EsquemaGeneral.kicad_pcb]
2022-10-22 Operacion salvar
    [EsquemaGeneral.kicad_pcb]
2022-10-22 a 1 error de terminar
    [EsquemaGeneral.kicad_pcb]
2022-10-22 EN BUSQUEDA DEL ERROR PERDIDO
    [EsquemaGeneral.kicad_pcb]
2022-10-22 Maldigo a la caché
2022-10-22 siuuuuuuuuuuuuuuuuuuuuuuuuuuuuuuuuuu :')
    [EsquemaGeneral.kicad_pcb]
2022-10-22 Aaaaaaaaaaaaaaa la cache es demasiado fuerte
2022-10-22 por si las moscas
    [EsquemaGeneral.kicad_pcb]
2022-10-22 Pines programacon de emergencia
    [Acondicionamiento.kicad_sch, EsquemaGeneral.kicad_pcb, EsquemaGeneral.kicad_sch, Luces_delanteras.kicad_sch, USB_UART.kicad_sch, alimentacion.kicad_sch, conn_sensores.kicad_sch]
2022-10-22 Lista para los chinos
    [Acondicionamiento.kicad_sch, EsquemaGeneral.kicad_pcb, EsquemaGeneral.kicad_sch, Luces_delanteras.kicad_sch, USB_UART.kicad_sch, alimentacion.kicad_sch, conn_sensores.kicad_sch]
2022-10-22 para los chinos con logo
    [EsquemaGeneral.kicad_pcb]
2022-10-22 Gerbers generados
    Cada vez más cerca
    [EsquemaGeneral-B_Cu.gbl, EsquemaGeneral-B_Mask.gbs, EsquemaGeneral-B_Paste.gbp, EsquemaGeneral-B_Silkscreen.gbo, EsquemaGeneral-Edge_Cuts.gm1, EsquemaGeneral-F_Cu.gtl, EsquemaGeneral-F_Mask.gts, EsquemaGeneral-F_Paste.gtp]
